L0czek/ESP32-Liligo-Disp-Temp-Hat/3d/T-Relay8-ESP32-3D.stp

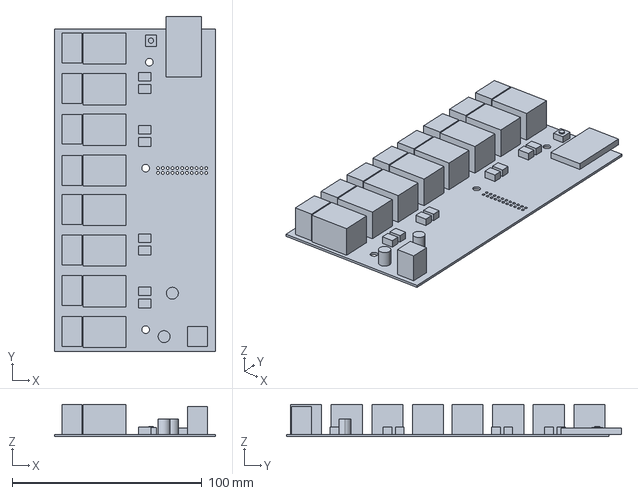
[picture p1: CAD file, 2026-11-12]
3d/T-Relay8-ESP32-3D.stp
85.0 x 176.5 x 16.9 mm
