L0czek/ESP32-Liligo-Disp-Temp-Hat/ESP32-Liligo-Disp-Temp-Hat.kicad_pcb

## KiCad design ESP32-Liligo-Disp-Temp-Hat.kicad_pcb (2026-11-12)

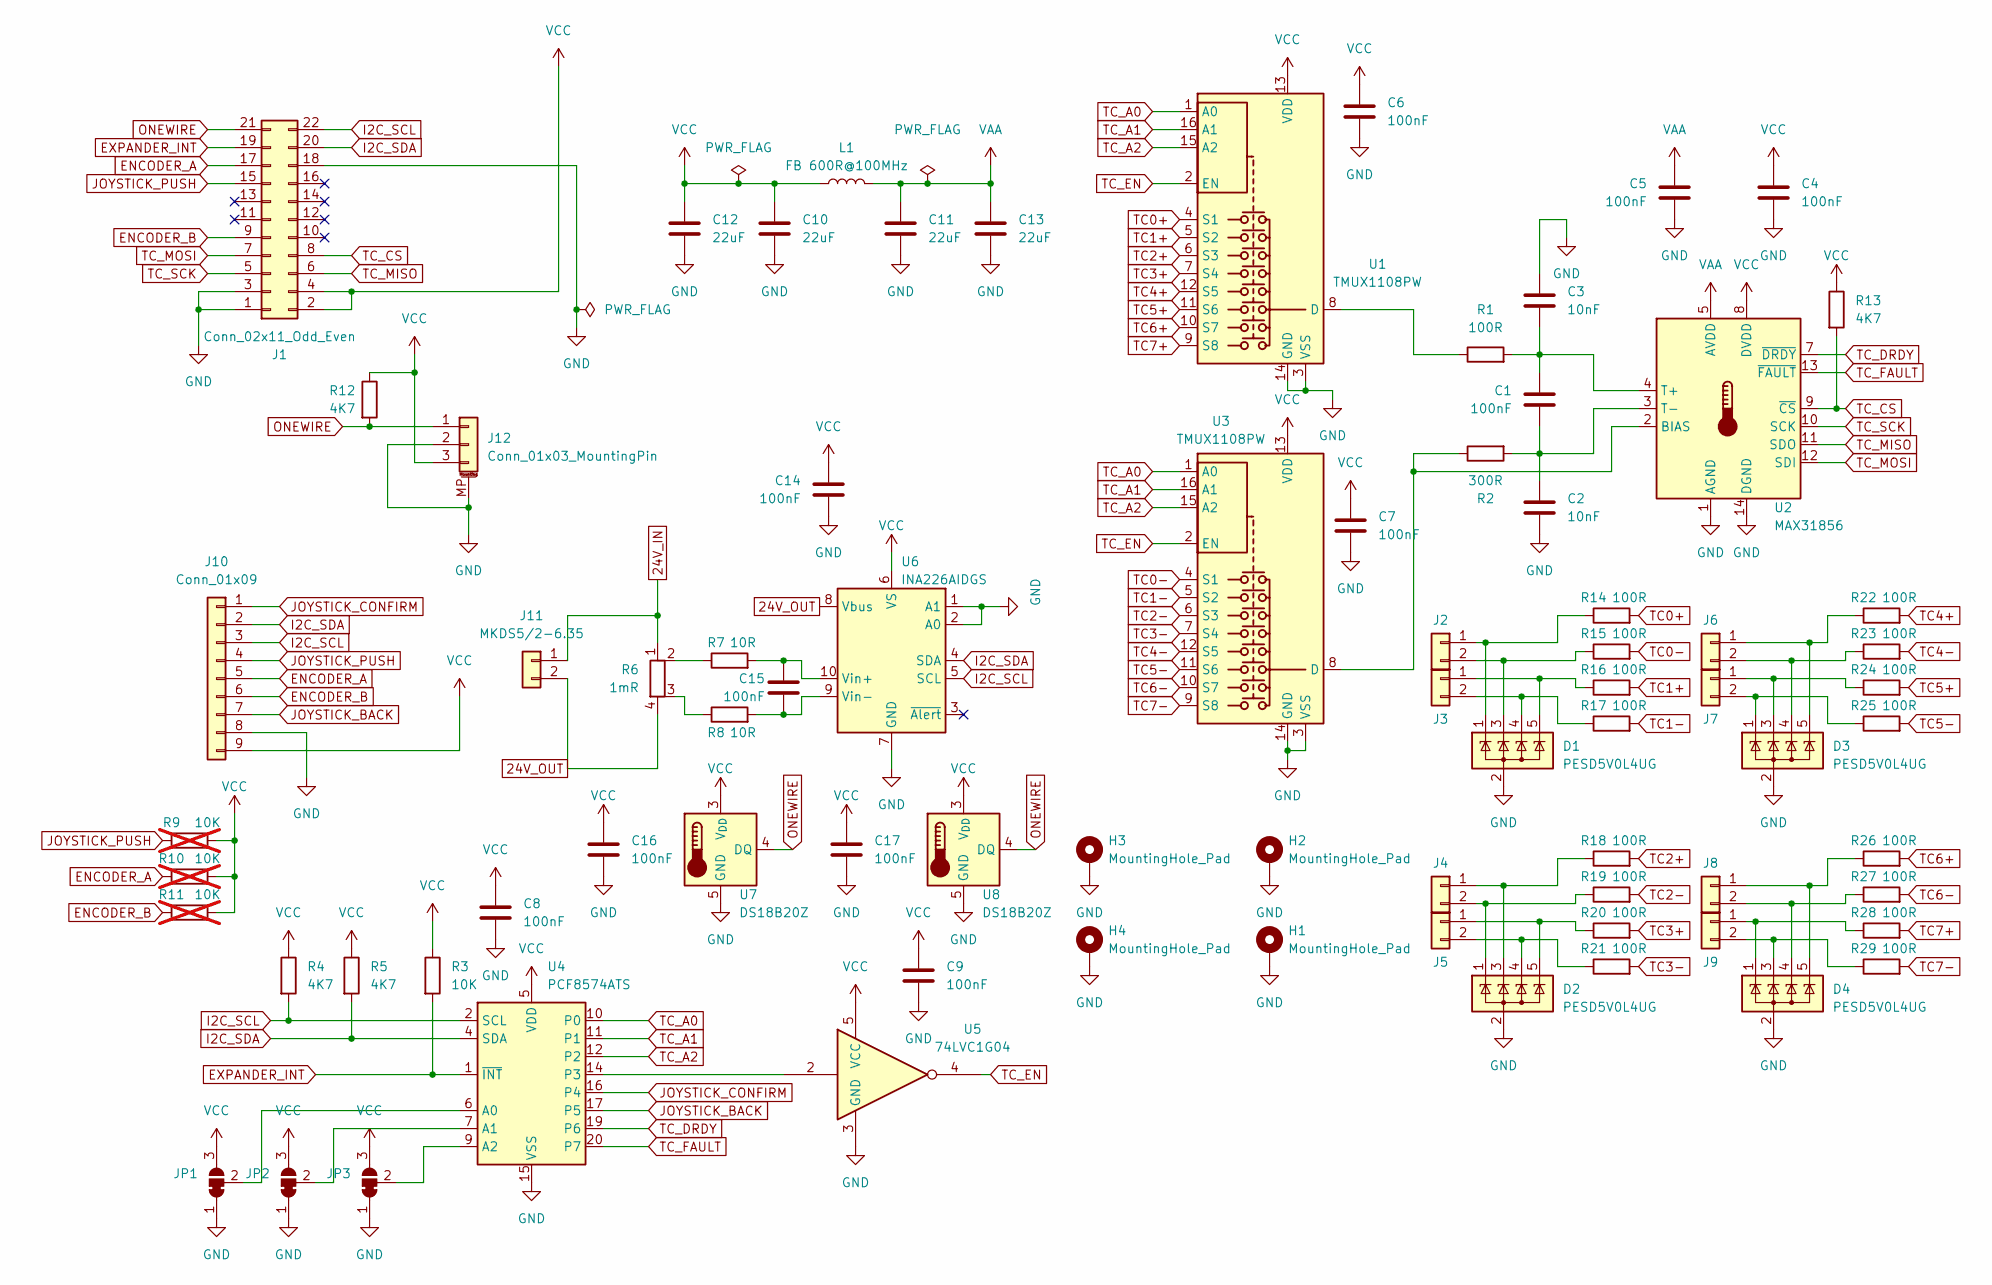
[picture p2: schematic ESP32-Liligo-Disp-Temp-Hat.kicad_sch]

Parts:
C1, C4, C5, C6, C7, C8, C9, C14, C15, C16, C17: 100nF; C_0805_2012Metric
C2, C3: 10nF; C_0805_2012Metric
C10, C11, C12, C13: 22uF; C_1206_3216Metric
D1, D2, D3, D4: PESD5V0L4UG; SOT-353_SC-70-5
H1, H2, H3, H4: MountingHole_Pad; MountingHole_3.2mm_M3_Pad_Via
J1: Conn_02x11_Odd_Even; PinSocket_2x11_P2.54mm_Vertical
J2, J3, J4, J5, J6, J7, J8, J9: Conn_01x02; PhoenixContact_MCV_1,5_2-G-5.08_1x02_P5.08mm_Vertical
J10: Conn_01x09; PinSocket_1x09_P2.54mm_Horizontal
J11: MKDS5/2-6.35; TerminalBlock_MetzConnect_Type701_RT11L02HGLU_1x02_P6.35mm_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
J12: Conn_01x03_MountingPin; JST_PH_S3B-PH-SM4-TB_1x03-1MP_P2.00mm_Horizontal
JP1, JP2, JP3: SolderJumper_3_Bridged12; SolderJumper-3_P1.3mm_Bridged12_RoundedPad1.0x1.5mm
L1: FB 600R@100MHz; L_0805_2012Metric
R1, R14, R15, R16, R17, R18, R19, R20, R21, R22, R23, R24, R25, R26, R27, R28, R29: 100R; R_0805_2012Metric
R2: 300R; R_0805_2012Metric
R3: 10K; R_0805_2012Metric
R4, R5, R12, R13: 4K7; R_0805_2012Metric
R6: 1mR; R_Shunt_Vishay_WSK2512_6332Metric_T2.21mm
R7, R8: 10R; R_0805_2012Metric
R9, R10, R11: 10K; R_0805_2012Metric; not fitted
U1, U3: TMUX1108PW; TSSOP-16_4.4x5mm_P0.65mm
U2: MAX31856; TSSOP-14_4.4x5mm_P0.65mm
U4: PCF8574ATS; SSOP-20_4.4x6.5mm_P0.65mm
U5: 74LVC1G04; SOT-23-5
U6: INA226AIDGS; TSSOP-10_3x3mm_P0.5mm
U7, U8: DS18B20Z; SOIC-8_3.9x4.9mm_P1.27mm

Connections:
24V_IN: J11.1, R6.1
24V_OUT: J11.2, R6.4, U6.8 (Vbus)
ENCODER_A: J1.17, J10.5, R10.1
ENCODER_B: J1.9, J10.6, R11.1
EXPANDER_INT: J1.19, R3.2, U4.1 (~INT)
GND: C2.2, C3.1, C4.2, C5.2, C6.2, C7.2, C8.2, C9.2, C10.2, C11.2, C12.2, C13.2, C14.2, C16.2, C17.2, D1.2 (A), D2.2 (A), D3.2 (A), D4.2 (A), H1.1 (1_1), H2.1 (1_1), H3.1 (1_1), H4.1 (1_1), J1.1, J1.3, J1.18, J10.8, J12.2, J12.MP (MountPin), JP1.1 (A), JP2.1 (A), JP3.1 (A), U1.3 (VSS), U1.14 (GND), U2.1 (AGND), U2.14 (DGND), U3.3 (VSS), U3.14 (GND), U4.15 (VSS), U5.3 (GND), U6.1 (A1), U6.2 (A0), U6.7 (GND), U7.5 (GND), U8.5 (GND)
I2C_SCL: J1.22, J10.3, R4.2, U4.2 (SCL), U6.5 (SCL)
I2C_SDA: J1.20, J10.2, R5.2, U4.4 (SDA), U6.4 (SDA)
JOYSTICK_BACK: J10.7, U4.17 (P5)
JOYSTICK_CONFIRM: J10.1, U4.16 (P4)
JOYSTICK_PUSH: J1.15, J10.4, R9.1
unnamed: D1.1 (K), J2.1, R14.1
unnamed: D1.3 (K), J2.2, R15.1
unnamed: D1.5 (K), J3.1, R16.1
unnamed: D1.4 (K), J3.2, R17.1
unnamed: D2.3 (K), J4.1, R18.1
unnamed: D2.1 (K), J4.2, R19.1
unnamed: D2.5 (K), J5.1, R20.1
unnamed: D2.4 (K), J5.2, R21.1
unnamed: D3.5 (K), J6.1, R22.1
unnamed: D3.4 (K), J6.2, R23.1
unnamed: D3.3 (K), J7.1, R24.1
unnamed: D3.1 (K), J7.2, R25.1
unnamed: D4.5 (K), J8.1, R26.1
unnamed: D4.4 (K), J8.2, R27.1
unnamed: D4.1 (K), J9.1, R28.1
unnamed: D4.3 (K), J9.2, R29.1
unnamed: JP1.2 (C), U4.6 (A0)
unnamed: JP2.2 (C), U4.7 (A1)
unnamed: JP3.2 (C), U4.9 (A2)
unnamed: R6.2, R7.1
unnamed: R6.3, R8.1
unnamed: R1.1, U1.8 (D)
unnamed: R2.1, U2.2 (BIAS), U3.8 (D)
unnamed: C1.1, C3.2, R1.2, U2.4 (T+)
unnamed: C1.2, C2.1, R2.2, U2.3 (T-)
unnamed: U4.14 (P3), U5.2
unnamed: C15.1, R7.2, U6.10 (Vin+)
unnamed: C15.2, R8.2, U6.9 (Vin-)
ONEWIRE: J1.21, J12.1, R12.2, U7.4 (DQ), U8.4 (DQ)
TC0+: R14.2, U1.4 (S1)
TC0-: R15.2, U3.4 (S1)
TC1+: R16.2, U1.5 (S2)
TC1-: R17.2, U3.5 (S2)
TC2+: R18.2, U1.6 (S3)
TC2-: R19.2, U3.6 (S3)
TC3+: R20.2, U1.7 (S4)
TC3-: R21.2, U3.7 (S4)
TC4+: R22.2, U1.12 (S5)
TC4-: R23.2, U3.12 (S5)
TC5+: R24.2, U1.11 (S6)
TC5-: R25.2, U3.11 (S6)
TC6+: R26.2, U1.10 (S7)
TC6-: R27.2, U3.10 (S7)
TC7+: R28.2, U1.9 (S8)
TC7-: R29.2, U3.9 (S8)
TC_A0: U1.1 (A0), U3.1 (A0), U4.10 (P0)
TC_A1: U1.16 (A1), U3.16 (A1), U4.11 (P1)
TC_A2: U1.15 (A2), U3.15 (A2), U4.12 (P2)
TC_CS: J1.8, R13.2, U2.9 (~CS)
TC_DRDY: U2.7 (~DRDY), U4.19 (P6)
TC_EN: U1.2 (EN), U3.2 (EN), U5.4
TC_FAULT: U2.13 (~FAULT), U4.20 (P7)
TC_MISO: J1.6, U2.11 (SDO)
TC_MOSI: J1.7, U2.12 (SDI)
TC_SCK: J1.5, U2.10 (SCK)
VAA: C5.1, C11.1, C13.1, L1.2, U2.5 (AVDD)
VCC: C4.1, C6.1, C7.1, C8.1, C9.1, C10.1, C12.1, C14.1, C16.1, C17.1, J1.2, J1.4, J10.9, J12.3, JP1.3 (B), JP2.3 (B), JP3.3 (B), L1.1, R3.1, R4.1, R5.1, R9.2, R10.2, R11.2, R12.1, R13.1, U1.13 (VDD), U2.8 (DVDD), U3.13 (VDD), U4.5 (VDD), U5.5 (VCC), U6.6 (VS), U7.3 (V_{DD}), U8.3 (V_{DD})

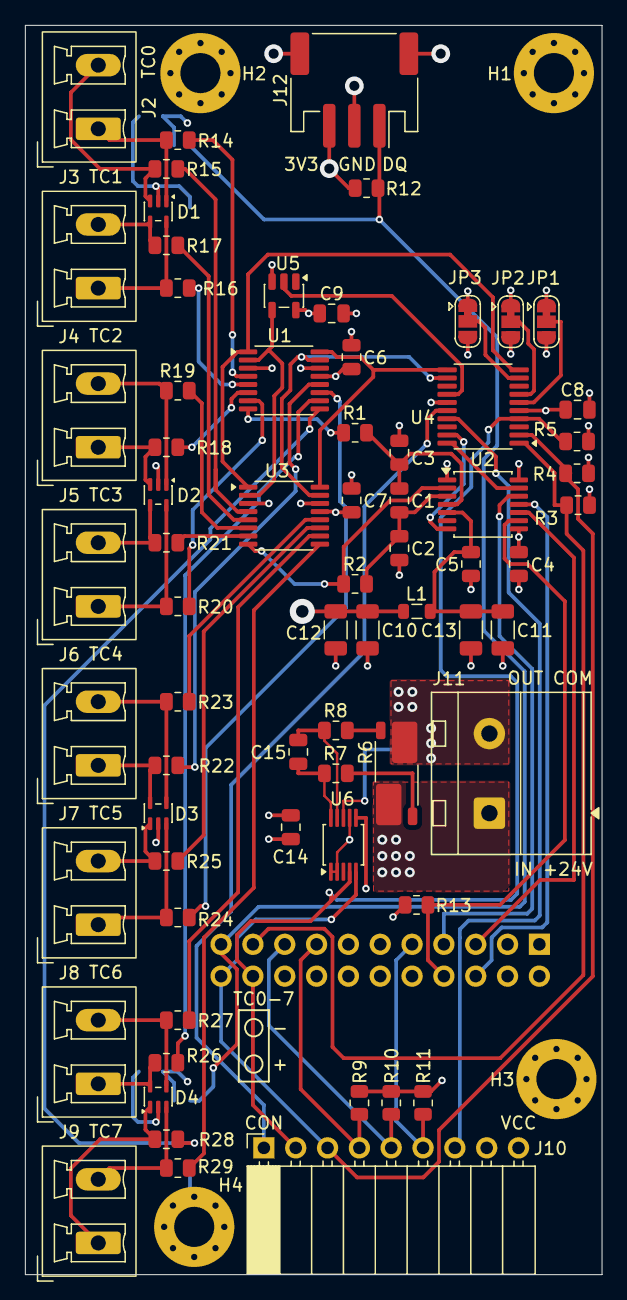
[picture p3: board ESP32-Liligo-Disp-Temp-Hat.kicad_pcb from above]

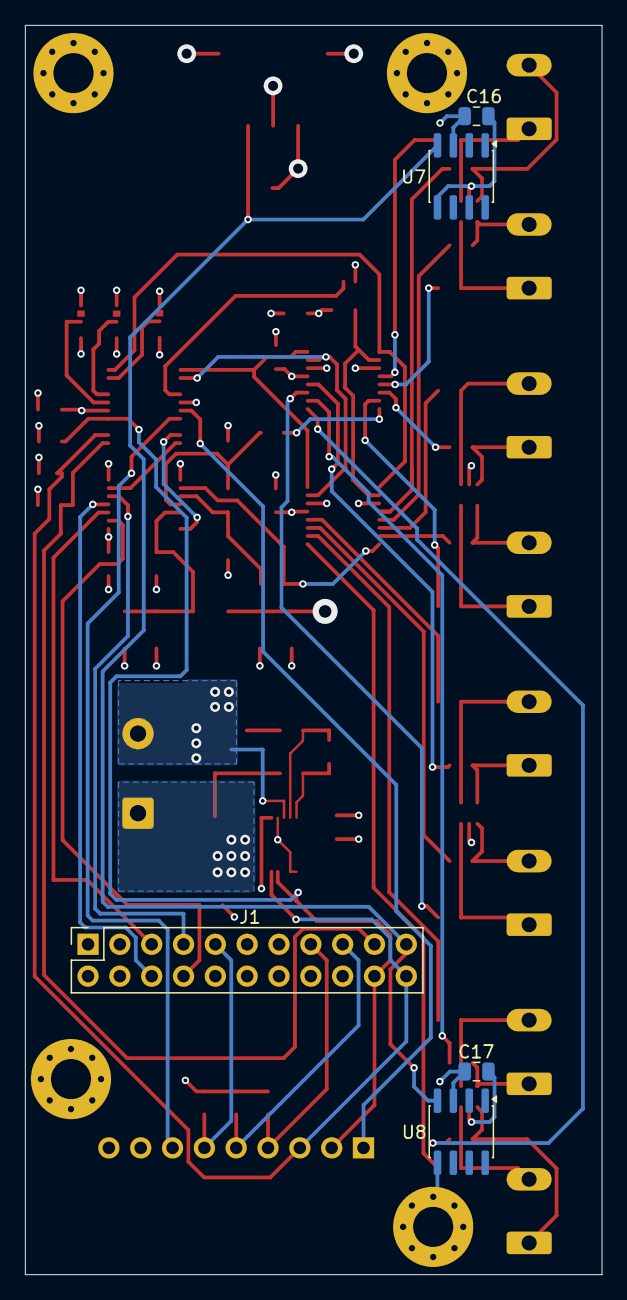
[picture p4: board ESP32-Liligo-Disp-Temp-Hat.kicad_pcb from below]

Board: 4 copper layers, 46.0 x 99.7 mm, 79 parts (5 on the bottom side), 68 nets.

Other parts of the board:
REF1: T-Relay-8 reference model
