L0czek/ESP32-Liligo-Disp-Temp-Hat/(commit log)

2026-10-23 Finish routing
    [ESP32-Liligo-Disp-Temp-Hat.kicad_pcb]
2026-10-25 Add onewire connector
    [ESP32-Liligo-Disp-Temp-Hat.kicad_pcb, ESP32-Liligo-Disp-Temp-Hat.kicad_sch]
2026-11-12 Add README with pin maps and review checklist
2026-11-12 Fix passive values: I2C pull-ups, bulk caps, L1 ferrite bead
    Review items 9, 10 and 11. No connections change.
    R4/R5 10K -> 4K7 (item 9)
    The front panel module has its own 10K pull-ups on SDA/SCL, so with
    the panel fitted the bus goes from 5K to about 3.2K (roughly 1 mA
    sink, well within I2C limits). The main gain is that the bus still
    has proper pull-ups when the panel is unplugged.
    C10-C13 20uF -> 22uF (item 11)
    20 uF is not a standard value; 22 uF is what can actually be bought.
    L1 "100uF" -> ferrite bead, 600R at 100 MHz, 0805 (item 10)
    The value was a typo (farads on an inductor), most likely meant as
    100 uH. L1 feeds VAA, the analog rail for the MAX31856 AVDD and the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
    [ESP32-Liligo-Disp-Temp-Hat.kicad_sch]
2026-11-12 Add TME part search skill
    Copied from the WWW22-rf project so parts for this board can be picked
    against live TME stock and prices (first use: a 30 A terminal block for
    J11). The skill's .env (API credentials) and OAuth token cache are
    gitignored and not part of this commit.
2026-11-12 Move heater current sensing to a high-side INA226
    Review item 4. Replaces the low-side INA215 + ESP32 ADC with an INA226
    on the +24 V feed, read over I2C.
    Why the old circuit had to go
    The 0.5 mOhm shunt sat between the heater return (J11.1) and the
    hat's GND. The hat's GND is also tied to the T-Relay through the J1
    ground pins and the mounting holes, so the 18.75 A return current had
    a second path home through the header and the T-Relay ground. That
    shifts the hat's ground against the ESP32's, which corrupts an
    analog reading and puts noise next to microvolt thermocouple
    signals. The amplifier's negative input was plain "GND" rather than
    the shunt pad, and the output went t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
    [ESP32-Liligo-Disp-Temp-Hat.kicad_sch]
2026-11-12 Replace J11 footprint with a generic 9.5 mm 30 A terminal block
    Review item 3. The old J11 was a Phoenix MCV 1,5 pluggable header
    rated about 8 A, carrying the heater's 18.75 A.
    Footprint is now KiCad's Ningbo-Kagnex HB9500 two-pole: 9.5 mm pitch,
    2 mm holes, 3.3 x 6.6 mm oval pads.
    Why a generic footprint rather than an exact one
    No 30 A part in stock at TME has a footprint in the stock KiCad
    library, and we did not want to draw a custom one. 9.5 mm is the
    usual pitch for generic 30 A blocks (tall screw blocks and barrier
    strips alike), so an oversized-hole 9.5 mm footprint takes whatever
    is on hand, or a wire soldered straight in.
    Default part: Degson DG638-9.52-02P (TME, 4.49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
    [ESP32-Liligo-Disp-Temp-Hat.kicad_sch]
2026-11-12 Remap J1 so 1-Wire sits on a bidirectional pin
    Review item 1.
    Problem
    On the ESP32, IO34/IO35/IO36/IO39 are input-only. ONEWIRE was on
    IO35, and a 1-Wire master has to pull the line low, so the bus could
    never work. The only bidirectional header pin not already taken by
    SPI or I2C was IO22, occupied by the push button.
    New assignment (hat J1 pin / ESP32 pin)
    22 / IO22 ONEWIRE (was JOYSTICK_PUSH)
    16 / IO39 JOYSTICK_PUSH (was ENCODER_B)
    10 / IO35 ENCODER_B (was ONEWIRE)
    20 / IO26 EXPANDER_INT (was CURRENT_SHUNT, removed with the INA215)
    15 / IO36 free (was EXPANDER_INT)
    18 / IO34 ENCODER_A (unchanged)
    Pure inputs now sit on the input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
    [ESP32-Liligo-Disp-Temp-Hat.kicad_sch]
2026-11-12 README: J1 is a bottom-mounted socket, note for layout
    The hat's J1 row numbering is mirrored against the T-Relay's P5
    (hat pin 1 mates with P5 pin 2). That is the natural result of a
    socket on the underside of the hat facing down onto the T-Relay's
    pin header, and it is what the review meant by soldering the
    connector on the bottom of the board.
    No schematic change is made for this: the mapping is already
    consistent, and renumbering the symbol would only move the same
    question into the footprint. The note lives in the README only, as
    agreed. It tells the layout pass to put the footprint on the back
    side and to confirm pad 1 lands on the 3V3 pin, since swapped rows
    would short 3V3 to GND.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
2026-11-12 Add pull-ups for 1-Wire, TC_CS and the panel inputs
    Review items 2, 6 and 7. Five new 0805 resistors to VCC.
    R12 4K7 on ONEWIRE (item 2)
    A 1-Wire bus is open-drain and does not work without a pull-up;
    the board had none, and the ESP32's internal pull-up (about 45K) is
    far too weak. 4.7K is the value from the DS18B20 datasheet.
    R13 4K7 on TC_CS (item 7)
    TC_CS is on IO4, which has an internal pull-down during and after
    reset, so until firmware drives it the MAX31856 is selected and
    drives its data output onto IO2. IO2 is a boot strap pin that must
    be low to enter the serial bootloader, so a selected MAX31856 can
    block flashing over UART. The pull-up keeps the chip deselected.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
    [ESP32-Liligo-Disp-Temp-Hat.kicad_sch]
2026-11-12 README: treat 18.75 A as the total of several heaters
    The earlier README flagged 18.75 A through one 10 A relay contact as
    an open problem. The more likely reading is that the system has
    several independently controlled heaters, one per relay, and 18.75 A
    (450 W at 24 V) is their sum: the review routes the measured feed to
    "relay COMs" in the plural, and the board pairs 8 relays with 8
    thermocouple inputs.
    Nothing in the schematic changes: J11 and the shunt carry the total
    either way and are already sized for it. The README now states this
    as a working assumption, notes that the INA226 sees only the total
    (per-heater current can be derived from the step when a relay
    switches), and keeps one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
2026-11-12 Add two optional DS18B20Z for cold-junction sensing
    Review item 8.
    Why
    A thermocouple gives the difference between its tip and the point
    where thermocouple wire meets copper, here the screw terminals
    J2-J9. The MAX31856 adds the cold-junction temperature back using
    its internal sensor, which measures the chip package. Any difference
    between chip and terminals goes into every reading one for one, and
    this board has heat sources that make such a difference likely and
    load-dependent: the shunt, copper carrying about 19 A, the relays
    and regulator on the T-Relay below, and the ESP32 radio.
    What
    U7, U8: DS18B20Z (SO-8), VDD on VCC (not parasite powered), DQ on
    the existing O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
    [ESP32-Liligo-Disp-Temp-Hat.kicad_sch]
2026-11-12 Protect the thermocouple inputs against ESD
    Review item 5.
    The 16 thermocouple lines ran from the screw terminals straight into
    the two TMUX1108 multiplexers. The MAX31856 behind them withstands
    +-45 V on its inputs, but the TMUX1108 allows only -0.5 V to
    VDD + 0.5 V on its signal pins (3.8 V here), is rated for 2 kV HBM
    and specifies no injection current. Long thermocouple wires running
    past relays and 24 V heaters therefore ended on the most fragile
    part of the board.
    Added, per line
    terminal -> ESD clamp to GND -> 100R -> multiplexer
    D1-D4: Nexperia PESD5V0L4UG, 4 clamps per SOT-353, one package per
    pair of terminals so each can sit right at its connectors.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
    [ESP32-Liligo-Disp-Temp-Hat.kicad_sch]
2026-11-12 Redraw the added circuitry for readability, back on A4
    No electrical change. A netlist comparison against the previous commit
    shows the same connections; the only differences are 16 terminal-side
    nets that lost their TCn_IN names (now auto-named) and R12/R13 drawn
    the other way up.
    The review additions had been dropped in as detached blocks: a
    table of 16 resistors and 16 loose diode units tied together only by
    labels on an enlarged A3 sheet, all five pull-ups in one group away
    from the signals they serve, and the DS18B20 capacitors apart from
    their sensors. The signal path could not be followed by eye.
    Thermocouple inputs
    Drawn inline in four identical cells, one per pair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
    [ESP32-Liligo-Disp-Temp-Hat.kicad_sch]
2026-11-12 Add PWR_FLAGs so ERC passes cleanly
    ERC had reported three "Input Power pin not driven by any Output Power
    pins" errors since before the review work, one each on VCC, GND and
    VAA. They were not real faults: the hat has no regulator of its own,
    3V3 and GND arrive through the J1 header (passive connector pins), and
    VAA is VCC behind the ferrite bead L1, so nothing on the sheet is a
    power output as far as ERC can tell.
    A PWR_FLAG on each of the three nets tells ERC where power comes
    from:
    VCC on the supply rail in front of L1
    VAA on the rail behind L1
    GND on the ground wire from J1 pin 17
    Each flag sits on an existing wire, which is split at that point. No
    connection changes; the net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
    [ESP32-Liligo-Disp-Temp-Hat.kicad_sch]
2026-11-12 Update PCB from schematic; README lists the layout work to do
    Board
    "Update PCB from Schematic" was run in the KiCad UI (it cannot be
    done from kicad-cli or the Python API), with footprints replaced
    from the symbols and links kept by symbol ID. Nothing has been
    placed or routed yet; this commit only brings the board's parts and
    nets in line with the reviewed schematic so that layout can start
    from a consistent state.
    Checked after the update: all 78 schematic parts have a footprint,
    every footprint matches its symbol's footprint field, every pad is
    on the net the schematic says (0 mismatches), and DRC's schematic
    parity check reports 0 problems.
    New footprints, unplac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
    [ESP32-Liligo-Disp-Temp-Hat.kicad_pcb]
2026-11-12 README: do not flip J1; record how the hat sits on the T-Relay-8
    Corrects wrong guidance from two earlier commits. The README told the
    layout pass to move the J1 footprint to the back side of the board.
    That would break the board: flipping a footprint in KiCad mirrors its
    pads, which swaps J1's two rows and puts 3V3 on GND.
    What is actually true, checked against the vendor DXF (which carries
    the silkscreen pin labels next to the header): the T-Relay has 3V3 at
    the right-hand end of the lower row when seen from above with the
    relays on the left. The hat's J1, as currently placed on the FRONT
    layer, has pad 1 (3V3) at the right-hand end of its lower row too. The
    schematic numbering was drawn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
2026-11-12 Place all parts, rip up old routing, add T-Relay outline and antenna keep-out
    Board work agreed with the user: Claude places the components, the
    user routes. Nothing is routed in this commit.
    Rip-up
    All 495 track and via items are removed. The series resistors and
    clamps had to go exactly where the thermocouple tracks ran, J11 is
    far larger, and several pads changed net (J11, C14, J1, J2-J9), so
    the old copper was mostly wrong or in the way. Starting clean is
    easier than routing around stale tracks. The VCC and GND planes on
    In1/In2 are kept and refilled.
    Placement (top side only, original 48 x 100 mm outline, no existing
    part moved)
    The T-Relay's relays are about 4 mm from t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
    [ESP32-Liligo-Disp-Temp-Hat.kicad_pcb]
2026-11-12 Move H1 so a resting spacer can support the far end of the hat
    The hat hangs on the J1 header alone, 78 mm from its far end, and its
    four mounting holes match nothing on the T-Relay.
    A screwed standoff was looked at and dropped. The T-Relay's only two
    holes under the hat are inside the J2-J9 terminal column: one under
    J3's pin, the other in the 1.4 mm gap between J7 and J8. Eight
    terminals fill the board's full height, so freeing either hole means
    taking a terminal out of the column and re-spacing the rest. That
    layout was drawn and rejected by the user.
    What is done instead: H1 moves from the top-right corner, where it
    hung past the T-Relay's edge, to (123, 92), which is over bare T-Relay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
    [ESP32-Liligo-Disp-Temp-Hat.kicad_pcb]
2026-11-12 Add the T-Relay-8 3D model under the hat for the 3D viewer
    Requested by the user, to see how the hat sits on the base board.
    3d/T-Relay8-ESP32-3D.stp is LilyGO's own model, unchanged, extracted
    from dxf/T-Relay8-ESP32-3D.7z in their LilyGo-T-Relay repository
    (272 KB, a simplified block model: board, relays, module, header).
    It is attached to a new footprint REF1 that exists only to carry the
    model: no pads, board-only so the schematic parity check ignores it,
    and excluded from the BOM and position files. Its anchor is the
    T-Relay's bottom-left corner, placed with the same offset as the
    Dwgs.User outline (J1 pad 1 over the T-Relay's 3V3 pin), so the model
    and the 2D outline agree.
    The mode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
    [ESP32-Liligo-Disp-Temp-Hat.kicad_pcb, T-Relay8-ESP32-3D.stp]
2026-11-12 Move the board drawing up so hat and T-Relay outline fit on the sheet
    The T-Relay reference outline is 170 mm tall and hung off the bottom
    of the A4 sheet, because the hat had been drawn low on the page.
    Everything on the board (footprints, outline, zones, rule area,
    reference drawings, the REF1 model footprint) is moved by the same
    vector, 66.04 mm up (26 x 2.54 mm, to stay on the 2.54 mm grid). The
    drawing now spans y = 13.5 to 191.1 mm on the 210 mm sheet, clear of
    the title block. Sheet size and orientation are unchanged; the user
    asked for that, and landscape A4 turned out to be enough.
    Nothing moves relative to anything else, so this is not a layout
    change: planes are refilled, DRC s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
    [ESP32-Liligo-Disp-Temp-Hat.kicad_pcb]
2026-11-12 Make the T-Relay outline and 3D model one footprint (REF1)
    Requested by the user: the 2D reference drawing and the 3D model
    should be a single thing.
    Until now the outline was 413 loose lines, circles and texts on
    Dwgs.User, and the 3D model sat on a separate pad-less footprint.
    They had to be kept aligned by hand, and the loose lines were easy to
    select or move one at a time.
    The same graphics are now drawn inside REF1, the footprint that
    already carries the model. Moving REF1 moves both, which matters
    because both must follow J1 if J1 is ever repositioned on the hat.
    REF1 is locked so it is not dragged by accident.
    No geometry changes: the outline is regenerated from the same vendor
    DXF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
    [ESP32-Liligo-Disp-Temp-Hat.kicad_pcb]
2026-11-12 Make the hat flush with the T-Relay and the placement symmetric
    Agreed with the user after comparing three options. The hat used to
    overhang the T-Relay by 5.6 mm on the right and 3.5 mm at the top.
    Outline and position
    The right edge comes in by 2.56 mm (board is now 45.7 x 99.7 mm) and
    the hat sits 3.0 mm further left and 3.5 mm lower on the T-Relay. On
    the hat that is J1 moving 3.0 mm right and 3.5 mm up, with the
    T-Relay reference REF1 moving with it. Top and right edges are now
    flush with the T-Relay's.
    The left shift is limited by the relays: they are 15.7 mm tall and
    now 1.6 mm from the hat's edge (4.5 mm before). That limit is why
    the board had to get narrower inste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
    [ESP32-Liligo-Disp-Temp-Hat.kicad_pcb]
2026-11-12 Restore original routing where it is still valid
    Requested by the user, to avoid routing everything from scratch.
    All 495 original track segments and vias had been removed. 137 of
    them (107 segments, 30 vias, in 33 connected pieces) are back, taken
    from the original board (commit 50cb41f) and shifted with the
    drawing.
    A connected piece of copper was restored only if
    - its net still exists under the same name,
    - every pad it touches is still on that net, and
    - none of those pads moved by more than 2 mm.
    Where a pad moved slightly (U1, U3, C6, C7 by 0.7 mm; JP3 by 0.6 mm),
    the track ends on it were moved by the same amount, so the last
    segment is stretched. Then DRC was run and any restored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
    [ESP32-Liligo-Disp-Temp-Hat.kicad_pcb]
2026-11-12 Make J1 a real bottom-side socket, numbered like the T-Relay header
    The user asked for J1 to be fixed properly, even at the cost of
    changing the schematic, instead of the 3D-model workaround tried
    before.
    The problem
    J1 is a socket soldered on the underside of the hat. The original
    design kept its footprint on the front layer and compensated in the
    schematic by numbering the two rows the other way round (hat pin 1
    = 3V3 mated with T-Relay pin 2). That was electrically correct, but
    the board showed the socket, its silkscreen and its courtyard on the
    wrong side, and the footprint could never be flipped, because
    flipping mirrors the pads and would have put 3V3 on GND.
    The fix, i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
    [ESP32-Liligo-Disp-Temp-Hat.kicad_pcb, ESP32-Liligo-Disp-Temp-Hat.kicad_sch]
2026-11-12 Shrink the VCC and GND plane outlines to the new board edge
    Spotted by the user: after the board was narrowed, the two plane
    zones on In1 and In2 still had their outline at the old right edge
    (x = 132.08), 2.5 mm outside the board (x = 129.54).
    It was cosmetic. KiCad clips zone fills to the board edge, so no
    copper was outside the board and DRC was clean. But a zone drawn
    larger than the board is confusing to look at and would grow back if
    the outline were ever widened again.
    Both outlines now end at x = 129.54. Fills are regenerated; DRC and
    schematic parity are unchanged.
    [ESP32-Liligo-Disp-Temp-Hat.kicad_pcb]
2026-11-12 Drop the antenna keep-out and put H1 back in the top-right corner
    Antenna keep-out removed
    It was added when the hat covered half the ESP32 antenna. Since the
    hat now stops at the T-Relay's top edge, the antenna sticks out
    beyond it and the rule area only cleared copper above the module's
    metal can. Its remaining benefit was small and unmeasured; its costs
    were visible: together with H1's ground pad it cut a corner out of
    the VCC plane, and it kept the planes away from J12's two ground
    mounting pads, which made those awkward to connect.
    H1 back in the corner
    H1 had been moved down and sideways to dodge the keep-out and the
    ESP32 module. With the keep-out gone it returns to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
    [ESP32-Liligo-Disp-Temp-Hat.kicad_pcb]
2026-11-12 Restore more of the original routing, including partial tracks as guides
    The user asked for as much of the old routing back as possible, even
    partially, including everything around J1 and the tracks heading for
    the thermocouple terminals, and will re-terminate what changed.
    Before this commit 137 of the 495 original track segments and vias
    were on the board; now 310 are (264 segments, 46 vias).
    How this pass differs from the first
    The first pass worked on whole connected pieces and dropped a piece
    if any pad it touched had moved or changed net. This pass works item
    by item:
    - A pad on the same net that moved up to 5 mm (was 2 mm) drags its
    track ends along. That brings back the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
    [ESP32-Liligo-Disp-Temp-Hat.kicad_pcb]
2026-11-12 Smaller heater connector, sensors at the ends of the terminal row
    Both agreed with the user after a planning round on why the board
    felt too tight to route.
    J11: Phoenix MKDS5/2-6.35 instead of the generic 9.5 mm footprint
    The generic footprint (chosen earlier so that any 30 A block would
    fit) took 21.6 x 18.9 mm and sat exactly where the heater path, J1
    and the SPI lines meet. The Phoenix part has the same 32 A / 4 mm2
    rating on 13.6 x 13.8 mm of courtyard and an exact stock KiCad
    footprint (Metz RT11L, 6.35 mm pitch, 1.3 mm holes; the user had
    already confirmed the hole size on the Phoenix drawing). Cost is
    about 3.50 zl more per board and the loss of the fits-anything
    foo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
    [ESP32-Liligo-Disp-Temp-Hat.kicad_pcb, ESP32-Liligo-Disp-Temp-Hat.kicad_sch]
2026-11-12 Tighten three design rules to JLCPCB's limits; add a 24 V net class
    The user asked whether DRC matches what the fab can do, and decided
    not to loosen anything below the project's existing values.
    Checked against JLCPCB's published capabilities for a 4-layer, 1 oz
    board without extra-cost options. The project's clearance (0.2 mm),
    minimum track (0.2 mm), via (0.5 / 0.3 mm), annular ring (0.1 mm) and
    edge clearance (0.3 mm) are all stricter than the fab requires and
    stay as they are. Three settings were looser than the fab's limits
    and are tightened:
    hole to copper 0.25 -> 0.28 mm (JLCPCB: plated hole to
    track 0.28 mm minimum)
    silkscree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
2026-11-12 Route the heater path: 24 V copper, Kelvin pair, INA226
    Step 4 of the routing plan agreed with the user.
    24 V copper
    The review asks for wide copper on both layers at the heater
    connector. It is drawn as two filled zones, 24V_OUT (J11 pin 2 to
    shunt pad 4) and 24V_IN (shunt pad 1 to J11 pin 1), each on F.Cu and
    B.Cu with solid pad connections. A zone is the same thing as a very
    wide track that follows the pad shapes; over the few millimetres
    between connector and shunt it gives 4.5 to 9 mm of width per layer.
    Fifteen 0.8 mm vias stitch front to back so the back layer carries
    its share from the surface-mount shunt pads.
    The VCC and GND planes underneath are left whole. Cut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
    [ESP32-Liligo-Disp-Temp-Hat.kicad_pcb]
2026-11-12 Route the thermocouple inputs: terminal, clamp, resistor, multiplexer
    Step 5 of the routing plan. All sixteen thermocouple lines are now
    connected from their terminal pin to their multiplexer input.
    The column is re-placed as four identical groups
    Trying to route the previous placement showed two problems. The
    series resistors of the two middle groups had been put level with
    the wrong pin of each connector, and with the clamp in the gap
    between two connectors the two outer lines of a group cannot reach
    it on one layer without crossing the inner lines.
    New pattern, the same for every pair of connectors: clamp in the gap
    between them, one resistor level with each pin, inner res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
    [ESP32-Liligo-Disp-Temp-Hat.kicad_pcb, ESP32-Liligo-Disp-Temp-Hat.kicad_sch]
2026-11-12 Straight thermocouple lines: multiplexers to the centre, J6-J9 channels reversed
    Review of the routed thermocouple section asked for three things.
    Resistor-to-multiplexer lines. The grid router had joined each resistor to
    the restored guide track of its net, which gave wandering paths with up to
    four vias. The guides were only guidance, so the section is laid out again
    around the one thing that makes the lines straight: U1 and U3 are turned 90
    degrees and sit side by side level with the J5/J6 gap, so one pin row faces
    the top four terminals and the other the bottom four. Each line is now a
    horizontal run from its resistor, one 45-degree corner and a vertical run
    into the pin.
    The TMUX1108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
    [ESP32-Liligo-Disp-Temp-Hat.kicad_pcb, ESP32-Liligo-Disp-Temp-Hat.kicad_sch]
2026-11-12 Default net class track width 0.4 -> 0.3 mm
    All signal tracks on the board were brought to 0.3 mm in the previous commit
    (0.4 mm did not fit three of the sixteen thermocouple lines, and one width
    for everything was preferred over a mix). The project default follows, so
    tracks drawn by hand from now on come out at the same width. Via size and
    clearance are unchanged; 0.3 mm is well above the 0.2 mm minimum-width rule.
    Done separately because KiCad rewrites the project file on exit and was open
    during the previous commit.
2026-11-12 Supply and ground connections for the new and moved parts
    VCC and GND are inner planes, so each supply pad gets its own via next to it
    instead of a track to a neighbour. After the multiplexers moved, 37 supply
    ratsnest lines were open; now none are, and the 38 that remain are signals.
    - U1/U3: pins 3 and 14 (both GND) face each other across the chip, so one
    track under the body joins them and one via below the south row serves
    both. A via at pin 3 itself was not possible on U3: U1's output runs on
    the back right underneath. Pin 13 (VCC) has its via under the body.
    - U7/U8: VCC via under the body; GND via directly beside the GND pin, because
    that pin is the DS18B20's main thermal pat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
    [ESP32-Liligo-Disp-Temp-Hat.kicad_pcb]
2026-11-12 Route multiplexer control and SPI; remove guide stubs from TC4-
    Multiplexer control (TC_A0..2, TC_EN, U4 P3 -> U5). The sixteen thermocouple
    lines enclose both multiplexers: the '+' fan on the front, the '-' fan on the
    back. So the same-named control pins of U1 and U3 cannot simply be joined.
    - U1 is reachable only on the front from the north. TC_EN and TC_A0 come
    straight down to its north pins. TC_A2 comes down beside them, passes
    between the two chips and runs under U1's body to pin 15 (the body ends
    have no pins). TC_A1 has no such way out, so pin 16 is joined to U3's pin 16
    by one front track in the 1.5 mm strip just below both chips.
    - U3 is open on the back to the east. Each o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
    [ESP32-Liligo-Disp-Temp-Hat.kicad_pcb]
2026-11-12 Route 1-Wire, EXPANDER_INT, the ESP32 side of I2C, and JP3
    J1's four left-hand pins (19 EXPANDER_INT, 20 SDA, 21 ONEWIRE, 22 SCL) are
    enclosed by the thermocouple lines on both layers: the '+' lines on the front
    and the '-' lines on the back all start at x = 99.6 and run east. West of
    that, under the protection column, the back layer is empty (the column is
    front-side SMD only), so that strip is used as a north-south corridor with
    four lanes.
    - ONEWIRE: J12 -> R12 -> a track under U7 to its pin -> via -> corridor ->
    J1 pin 21. The lane order is fixed by who leaves the corridor first, which
    puts 1-Wire on the east lane; to reach U8 below J1 it then has to cross the
    I2C lanes, so it lea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
    [ESP32-Liligo-Disp-Temp-Hat.kicad_pcb]
2026-11-12 Tidier pin entries at the left end of J1
    - EXPANDER_INT came up between J1's first two pin columns, looped over the
    top of the connector and dropped into pin 19 from above. It now enters the
    pin diagonally from between the two pin rows; the loop above J1 is gone.
    - 1-Wire to U8 left pin 21 westward on the front, ran down through the gap
    between R27's pads, changed layer and came back east. It now goes straight
    down on the front between the first two pin columns (crossing the I2C lines
    there), with its via just below J1. No track between a thermocouple
    resistor's pads any more, and about 6 mm shorter.
    The overall shape stays: SCL, SDA and the interrupt line still come in from
    the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
    [ESP32-Liligo-Disp-Temp-Hat.kicad_pcb]
2026-11-12 I2C and EXPANDER_INT: down beside the U3 bundle instead of round the corner
    SCL, SDA and the interrupt line ran along the top edge to the right-hand
    corner and down past the jumpers. They now cross the top only as far as the
    U3 line bundle, turn down immediately to the right of it (x = 113.0-114.2,
    free above y = 41) and pass under JP1-JP3 on the back to U4's right-hand
    pins and the pull-ups. About 113 mm for SCL instead of 130 mm, still one via
    per line, nothing else moved.
    The run across the top cannot be avoided on this layer: the eight '-' lines
    form a closed fan from the resistor column to U3, and the only opening for
    lines coming up the column is above the top-most '-' via.
    This is a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
    [ESP32-Liligo-Disp-Temp-Hat.kicad_pcb]
2026-11-12 Cold-junction sensors to the back, under the ends of the protection column
    Review item 8 wanted one DS18B20 at each end of the J2-J9 row, reading the
    terminal temperature. On the front they had ended up about 19 mm from the
    terminal pins, because the '+' thermocouple lines leave no room nearer.
    The back side under the column is empty, so U7 and U8 move there: centres
    about 4 mm from the line of terminal pins, U7 beside J3's upper pin, U8
    beside J8's lower pin, same orientation. C16/C17 follow. These are the
    board's only bottom-side parts; accepted because of what the sensors are for.
    - Supply vias: a via under the column would hit the front-side resistors and
    clamp arrays, so each via sit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
    [ESP32-Liligo-Disp-Temp-Hat.kicad_pcb]
2026-11-12 I2C from the right-hand side; JOYSTICK_PUSH and both encoder lines
    I2C. SDA and SCL no longer use the corridor or the top of the board.
    - Front layer, no vias: U6 pins -> through J1 between pin columns (x = 110.57
    and 113.11) -> diagonals to J10 pins 2 and 3.
    - To U4: one via each just below J1, then the back layer along J1's underside
    and up the strip between the heater copper and the right edge, to vias on
    the existing tracks at R4/R5. The original board also took I2C round this
    side.
    - To the ESP32 (J1 pins 20, 22): from the J10 pins on the back, through the
    0.9 mm slot between the J9 '-' via and H4 (two tracks at exactly minimum
    clearance), and 15 mm up the corridor.
    Panel s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
    [ESP32-Liligo-Disp-Temp-Hat.kicad_pcb]
2026-11-12 Route JOYSTICK_BACK and JOYSTICK_CONFIRM; the board is fully routed
    These two had no obvious path: both leave U4 on the side facing away from
    the right-hand strip, and JOYSTICK_CONFIRM's J10 pin is the left-most one,
    behind the I2C lines. The paths were found by letting the grid router search
    the whole board, then redrawn by hand with straight runs and 45-degree
    corners.
    JOYSTICK_BACK: back layer only, no new via. J10 pin 7 -> diagonally to the
    J1 gap at x = 110.57 (passing west of the two I2C vias below J1) -> north
    just west of the heater copper, between U6's vias -> diagonally under the
    supply filter to U4's existing via. Its old guide into the right-hand strip
    is removed; it could never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
    [ESP32-Liligo-Disp-Temp-Hat.kicad_pcb]
2026-11-12 Refresh board and schematic from KiCad (no functional change)
    Three operations done in the KiCad GUI, committed together because none of
    them changes the design:
    - Update PCB from schematic: refreshed footprint metadata only. J11 gained
    the symbol's footprint filter and unit info and its pin names became
    Pin_1_1 / Pin_2_2 (left over from the symbol swap), and the "no connect"
    marker on J1's pads moved to the pins that are really unused (left over
    from mirroring J1).
    - Update footprints from library: the eight terminal blocks, U4 and J1 now
    match the current library versions, which removes the ten
    lib_footprint_mismatch warnings. Two pads read 0.01 mm different in
    position (rou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
    [ESP32-Liligo-Disp-Temp-Hat.kicad_pcb, ESP32-Liligo-Disp-Temp-Hat.kicad_sch]
2026-11-12 Variant: multiplexers back beside U2 (experiment)
    A what-if branch, not a replacement for master. Moving the multiplexers to
    the centre of the terminal row was the one large layout change on master
    that was a choice rather than a consequence of the review, and it cost the
    compact analog front end the original board had. This branch puts U1, U3,
    U5, C6, C7 and C9 back at their original positions and re-routes what
    depends on them, keeping everything else from master. The schematic is
    unchanged (the J6-J9 channel order still suits this arrangement: the
    bottom-half lines reach the right-hand pin column from below).
    Routing:
    - Top-half '+' lines: front layer, two lanes in the 1.9 mm between the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
    [ESP32-Liligo-Disp-Temp-Hat.kicad_pcb]
2026-11-12 Variant, second pass: J6-J9 pairs closer together, 45-degree clean-up
    - The '-' lanes of J6..J9 move 2.2 mm west, to 3.8 mm from their '+'
    partners instead of 6 mm, which shrinks the open loop each pair forms on
    its way north. Each lane now ends on its own via under U3, reached
    straight from the south (the four vias step east as they go south), so the
    short horizontal runs into U3 from the east are gone. The '-' lines get
    1-6 mm shorter.
    - Stacking the '-' lanes exactly under the '+' lines was considered and
    rejected: it would close both layers from J1 to U3 and JOYSTICK_CONFIRM,
    which has to cross that strip, would have no path.
    - C14's two vias move west of the new lanes; JOY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
    [ESP32-Liligo-Disp-Temp-Hat.kicad_pcb]
2026-11-12 Move the back-side sensors 1.1 mm away from the terminal pads
    U7 and U8 sat 0.3 mm from the terminals' through-hole pads, which is legal
    but leaves little room for soldering parts on the back next to large
    through-hole joints. Both move 1.1 mm to the right (same amount, so they
    stay symmetric); the gap is now 1.4 mm. They are still about 5.4 mm from the
    line of terminal pins.
    1.1 mm is what fits: at U8 the three back-layer lanes beside it
    (JOYSTICK_CONFIRM, SCL, SDA) move 0.4 mm east, which uses up the room to the
    '-' vias. At U7 the 1-Wire lane moves to x = 97.85 and steps back to 96.75
    above J1; at U8 it now ends directly on the sensor's pin. U7's supply stub
    leaves its pad diagonally bec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
    [ESP32-Liligo-Disp-Temp-Hat.kicad_pcb]
2026-11-12 Move two vias off chip pads; README: board state and remaining work
    Board:
    - The TC_A0 via at U3 overlapped pin 1's pad by 0.18 mm. It moves 0.6 mm up
    to just above the pad (pin 1 is the top pin of that column) with a short
    diagonal stub into it.
    - The J9 '-' via under U3 overlapped pin 12's pad by 0.07 mm. The four '-'
    lanes of J6..J9 keep their spacing (each lane passes its neighbour's via
    at exactly the minimum clearance), so all four move 0.15 mm west together.
    A via that sits partly on a pad can pull solder away from the joint. The
    third case found, the supply via at C8, is original and stays.
    README:
    - The "PCB layout tasks" section described a board with restored guide
    trac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
    [ESP32-Liligo-Disp-Temp-Hat.kicad_pcb]
2026-11-12 master becomes the starting point for hand routing
    The scripted routing is complete but replaced about 92 % of the original
    layout. It now lives on the branch `scripted-routing` (at c2ee71e). master
    goes back to the original board as far as the review allows, so that the
    remaining routing can be done by hand on top of the original work.
    Kept from the scripted work:
    - The reviewed schematic, with J1 mirrored so its pin numbers equal the
    T-Relay's header and the footprint on the back.
    - REF1 with the T-Relay outline and 3D model, lined up with J1.
    - The heater path as built: 24V_IN / 24V_OUT zones on both outer layers with
    their stitching vias, the Kelvin pair, U6's own connections, and t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
    [ESP32-Liligo-Disp-Temp-Hat.kicad_pcb, ESP32-Liligo-Disp-Temp-Hat.kicad_sch]
2026-11-12 Hand routing, cleaned up: exact positions, exact angles, more spacing
    The board was routed by hand in KiCad (branch `hand-routed`, d10954e).
    That draft is the reference for where everything goes; this commit is the
    same routing with the rough edges removed by script, as asked: messed-up
    traces, symmetry and precision, and no tighter spacing than necessary.
    Precision
    - The freehand move of everything except J1 was (-3.32, +0.045) mm. It is
    now exactly (-3.30, 0), so all parts are back on their original y and a
    round x offset.
    - Parts that belong on a pin's axis are exactly on it (series resistors
    level with terminal pins, clamps centred between the inner pins, R9-R11
    above their J10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
    [ESP32-Liligo-Disp-Temp-Hat.kicad_pcb]
2026-11-12 Board flush with the T-Relay: 3.5 mm down, right edge cut, J1 area redrawn
    Asked for: no overhang at the top, no overhang on the right, traces fixed.
    Fit
    - Everything except J1 and REF1 moves 3.5 mm down, so the hat's top edge is
    on the T-Relay's top edge.
    - The outline's right edge moves from 128.78 to 126.54, the T-Relay's edge
    (46.0 x 99.7 mm). Plane outlines follow. No copper is closer than 0.59 mm
    to the new edge.
    Consequences that had to be redrawn (J1 is now 3.5 mm closer to the heater
    copper and its left pins sat on three tracks):
    - Back-side bundle (SDA, 1-Wire, MOSI, JOYSTICK_BACK, MISO): the diagonals
    into J1 would have cut through the 24V_IN zone corner. They now turn i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
    [ESP32-Liligo-Disp-Temp-Hat.kicad_pcb]
2026-11-12 D1, D4: ground via outside the clamp; sensors U7/U8 placed symmetrically
    The ground vias of D1 and D4 were still between the clamps' pad rows. They
    could not simply move out as at D2/D3, because the cold-junction sensors
    sit on the back right there and the spot outside the clamp fell on their
    pads.
    Placement (asked for: symmetric if the sensors have to move)
    - U7 at (91.75, 32.0625) and U8 at (91.75, 108.30), mirror images about the
    middle of the terminal row (y = 70.18125). U7 moves 3.7 mm up, U8 3.1 mm
    down. The position is the only one that works at both ends: D1's and
    D4's vias come out between each sensor's two pad rows, and at U8 the
    TC7+ track (y = 109.2) passes between the r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
    [ESP32-Liligo-Disp-Temp-Hat.kicad_pcb]
2026-11-12 TC4+ and TC6+ follow their minus lines up the inside
    The loop between the + and - of a thermocouple pair is what picks up the
    heater current switching. TC6+ ran round the outside of the terminal row on
    the back (x = 83) while TC6- runs up the inside on the front, on average
    8.2 mm apart over 72 mm.
    - TC6+ now goes straight up at x = 93.27 on the back, under the first
    stretch of TC6-, and joins its old diagonal to U1 at (93.27, 63.90).
    Mean distance to TC6-: 8.2 -> 4.2 mm, 12 mm shorter.
    - TC4+ had a detour to x = 90.12 that lay across that lane. It now runs at
    x = 94.05 beside TC4- and joins its old diagonal. Its via moves 0.24 mm
    right to clear the TC6+ lane. Mean distance to TC4-: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
    [ESP32-Liligo-Disp-Temp-Hat.kicad_pcb]
2026-11-12 J1: one track per pin gap, no front track on top of a back track
    Asked for: the lines between J1's pins overlap front and back; make it
    more like the original, where each gap carries one track.
    Three gaps carried a front and a back track on the same axis:
    - pins 17/15: JOYSTICK_PUSH (front) over ENCODER_A (back), 7.8 mm
    - pins 7/5: TC_CS (front) over JOYSTICK_BACK (back), 1.8 mm
    - pins 21/19: I2C_SDA (front) over I2C_SCL (back), 1.8 mm
    Two are separated by using a free neighbouring gap:
    - ENCODER_A leaves pin 17 to the left and runs down the gap between pins
    19 and 17, then joins its old diagonal to J10.
    - TC_CS leaves pin 8 to the left and runs up the gap between pins 9 and 7.
    R13 m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
    [ESP32-Liligo-Disp-Temp-Hat.kicad_pcb]
2026-11-12 README: describe the board as it is, list only what remains
    The layout section had grown into a log of the steps (hand routing,
    clean-up, move, redraws). It now describes the current placement and
    routing in one pass, with the reasons that are still needed to understand
    the board: why R19/R24 sit off their pin axis, why the sensors are where
    they are, why TC7+ goes round the outside, why one J1 gap still carries two
    tracks, where the tightest spots are.
    Removed: the section on lessons from the scripted routing (it was guidance
    for the hand routing, which is done; it stays in the history), the done
    items in "Remaining work", and the description of the clean-up script.
    "Remaining work" lists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
2026-11-12 Second review pass: plane clearance 0.2 mm, README records what was checked
    A full re-review after the fixes found no electrical error in the schematic
    or the copper (ERC 0, DRC 0 on copper, parity 0). This commit holds the one
    board change that came out of it and the README updates.
    - VCC (In1) and GND (In2) zone clearance 0.3 -> 0.2 mm, zones refilled.
    At 0.3 mm the clearance holes of J1's 22 pins (1.7 mm pads on 2.54 mm
    pitch) merged into one 27 mm slot in both planes, because the 0.24 mm
    left between pins was under the 0.25 mm minimum fill width. At 0.2 mm
    0.44 mm of copper stays between pins and both planes are continuous
    through J1. 0.2 mm is the clearance the rest of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
    [ESP32-Liligo-Disp-Temp-Hat.kicad_pcb]
2026-11-12 README: J10 pin order confirmed from the panel's silkscreen; direct plug-in is open
    The previous commit said J10's order had never been checked on a real
    module. The seller's listing photos show the silkscreen on both sides of
    the panel, which is as good as having it in hand for this question:
    - front: CON SDA SCL PSH TRA TRB BAK GND VCC, square pad at VCC
    - back: CONFIRM OLED_SDA OLED_SCL ENCODER_PUSH ENCODER_A ENCODER_B BACK
    GND 3V3
    J10 pins 1-9 carry exactly these signals in this order, so the net
    assignment is right and a 1:1 cable works.
    What the photos also settle is the geometry. In a horizontal socket the
    panel can sit four ways. The two with the right pin order are unus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
2026-11-12 Silkscreen: reference names re-placed, functional labels added
    DRC listed 102 silkscreen warnings: names over pads, over each other, over
    other parts' outlines and off the board edge. Nothing had been tidied
    since the parts moved. Only text was touched here: no part, track, via or
    zone moved, and the board differs from the previous commit in the 78
    reference positions plus new board-level text and six graphic items.
    Reference names
    - All stay 1.0 mm / 0.15 mm, the board's own minimum text height, and are
    clear of pads, other parts' bodies, each other and via holes.
    - Protection column: each name directly right of its own part. A single
    aligned column was tried first; because the parts a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
    [ESP32-Liligo-Disp-Temp-Hat.kicad_pcb]
2026-11-12 README: BOM as two orders (TME and Mouser), every part sourced
    "Chosen parts" held the handful of picks made during the review. It is
    replaced by a full BOM, built to the user's usual rules: common resistor
    and capacitor values and plain pin headers are assumed to be on hand and
    only listed; everything else is the cheapest part that is in stock and
    sold in prototype quantities.
    Why two orders
    - TME does not sell the MAX31856 at all (only MAX31855/MAX31850), and has
    stock 0 for the Phoenix MC 1,5 thermocouple headers and plugs. Mouser
    has all three, so a Mouser order is needed whatever else is decided.
    - Three parts TME does have are marked "-> M", better from Mouser once
    that order ex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
2026-11-12 Inner planes keep 0.5 mm from the 24 V nets
    The fifteen 24V stitching vias and both J11 pins pass through the VCC
    (3V3) and GND planes. Until now the planes cleared them by the board's
    general 0.2 mm, while the 24V zones on the outer layers already keep
    0.5 mm from everything else. 0.2 mm is within the fab's limits, but a
    short at that spot would put the heater supply (24 V, about 19 A
    available) on the ESP32's 3V3 rail, so the margin is worth having where
    it costs nothing.
    Done as a custom rule in a new .kicad_dru file rather than as a net
    class clearance: a net class clearance would also apply at U6 pin 8
    (Vbus, 0.5 mm pin pitch) and could not be met there. The rule only
    applies between P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
    [ESP32-Liligo-Disp-Temp-Hat.kicad_pcb]
2026-11-12 README: the panel plugs into J10 on a right-angle header, lying flat
    The open question was how the display panel connects. As drawn, J10 (a
    horizontal socket on the hat's lower edge) does not work with the panel
    plugged in the obvious way: with the straight header that comes with the
    panel, the panel stands up at the hat's edge facing outwards, which
    reverses the pin order (VCC on J10 pin 1) and also puts the panel's corner
    into a relay. The position with the right order hangs down through the
    T-Relay board. Mirroring J10 was the fix on the table, at the cost of
    rerouting nine nets.
    The user's idea removes the need for any board change: fit a right-angle
    1x9 header on the panel instead. The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
